kuro68k/Volume-Control/README.md

# Volume-Control
USB volume control and companion app
