kuro68k/Volume-Control/research/lighthouse-bi-colour-red-white-dimensions.jpg

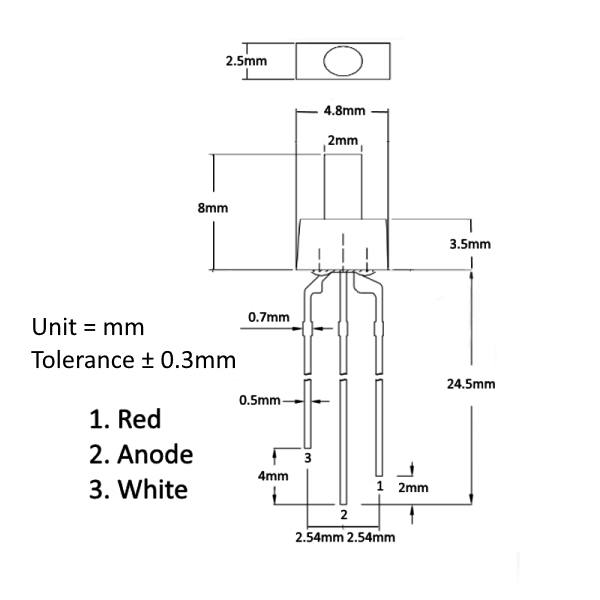
research/lighthouse-bi-colour-red-white-dimensions.jpg
