kuro68k/Volume-Control/hardware/usb_volume_control - Digikey 2026-02-26.ods

Reference | Qty | Value | Footprint | Description
C1 | 1 | 470n | Capacitor_SMD:C_0805_2012Metric_Pad1.18x1.45mm_HandSolder | Unpolarized capacitor
C2,C3,C5 | 3 | 100n | Capacitor_SMD:C_0805_2012Metric_Pad1.18x1.45mm_HandSolder | Unpolarized capacitor
C10 | 1 | 10u | Capacitor_SMD:C_0805_2012Metric_Pad1.18x1.45mm_HandSolder | Unpolarized capacitor
D1,D2,D3,D4,D5 | 5 | RW | LED_THT:LED_D3.0mm-3 | Dual LED, common anode on pin 2
H1,H2 | 2 | MountingHole_Pad | AliExpress M3 Bracket:MountingBracket_3.2mm_M3_Pad_tall | Mounting Hole with connection
J1 | 1 | AVR-PDI-6 | Connector_PinHeader_2.54mm:PinHeader_2x03_P2.54mm_Vertical | Atmel 6-pin PDI connector
J2 | 1 | USB_C_Skt_USB2.0_16P | Connector_USB:USB_C_Receptacle_GCT_USB4105-xx-A_16P_TopMnt_Horizontal | USB 2.0-only 16P Type-C Receptacle connector
J3 | 1 | RGB_LED | Connector_PinHeader_2.54mm:PinHeader_1x04_P2.54mm_Vertical | Generic connector, single row, 01x04, script generated (kicad-library-utils/schlib/autogen/connector/)
J4 | 1 | CAPBTN | Connector_PinHeader_2.54mm:PinHeader_1x04_P2.54mm_Vertical | Generic connector, single row, 01x04, script generated (kicad-library-utils/schlib/autogen/connector/)
J5 | 1 | ENC | Connector_PinHeader_2.54mm:PinHeader_1x03_P2.54mm_Vertical | Generic connector, single row, 01x03, script generated (kicad-library-utils/schlib/autogen/connector/)
J6 | 1 | BTN | Connector_PinHeader_2.54mm:PinHeader_1x02_P2.54mm_Vertical | Generic connector, single row, 01x02, script generated (kicad-library-utils/schlib/autogen/connector/)
R1,R2 | 2 | 5k6 | Resistor_SMD:R_0805_2012Metric_Pad1.20x1.40mm_HandSolder | Resistor
R3,R4,R5,R6,R7,R8,R9,R10,R11,R12 | 10 | 470 | Resistor_SMD:R_0805_2012Metric_Pad1.20x1.40mm_HandSolder | Resistor
U1 | 1 | AVR16DU14 | Package_SO:SOIC-14_3.9x8.7mm_P1.27mm | AVR microcontroller, 16kB flash, USB
U2,U3 | 2 | SN74ACT596 | Package_SO:TSSOP-16_4.4x5mm_P0.65mm | 8-bit serial in/out Shift Register Open Collector Outputs
