kuro68k/Volume-Control/CAD/EM14RXD-M20-L.stp

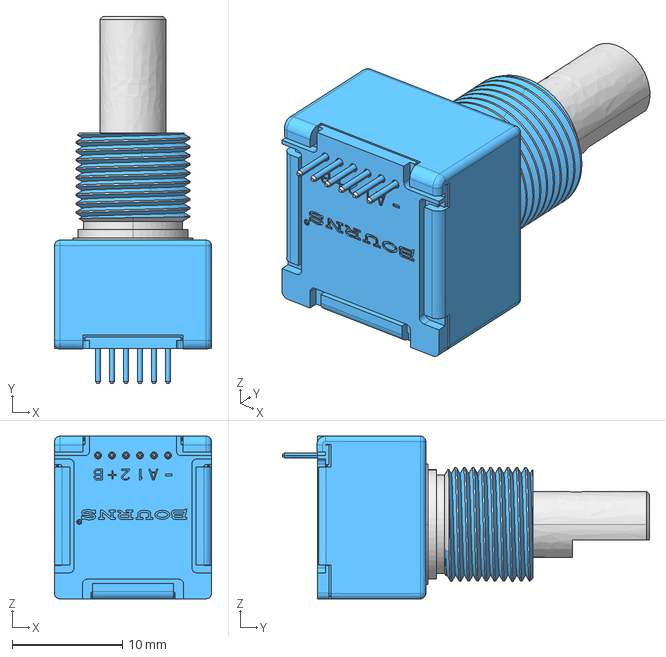
[picture p2: CAD file, 2026-02-12]
CAD/EM14RXD-M20-L.stp
14.2 x 33.3 x 14.8 mm
