kuro68k/Volume-Control/CAD/other/knob_20mm_6mm_shaft.stl

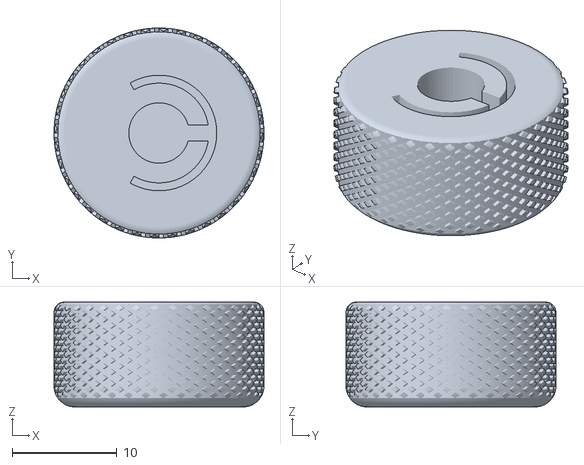
[picture p3: CAD file, 2026-02-12]
CAD/other/knob_20mm_6mm_shaft.stl
20.0 x 20.0 x 10.0
