kuro68k/Volume-Control/CAD/output/enclosure EX11-3-8 Front Plate.step

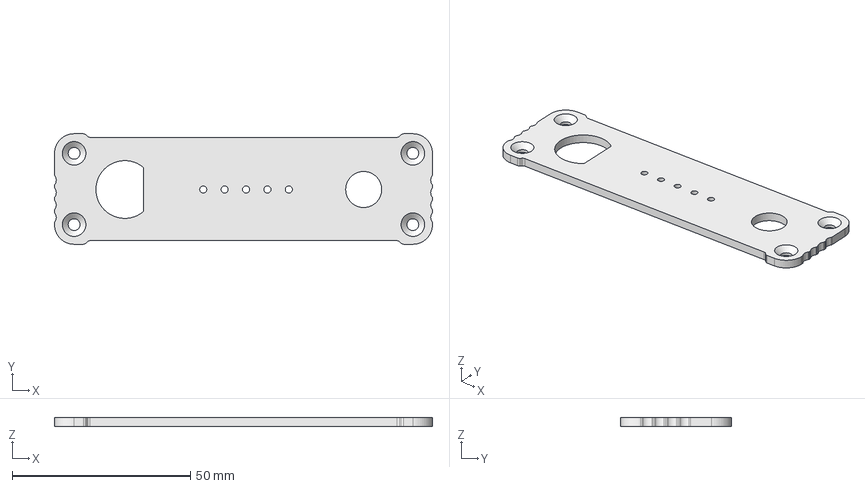
[picture p4: CAD file, 2026-02-13]
CAD/output/enclosure EX11-3-8 Front Plate.step
106.0 x 31.0 x 2.50 mm
