kuro68k/Volume-Control/usb_volume_control.step

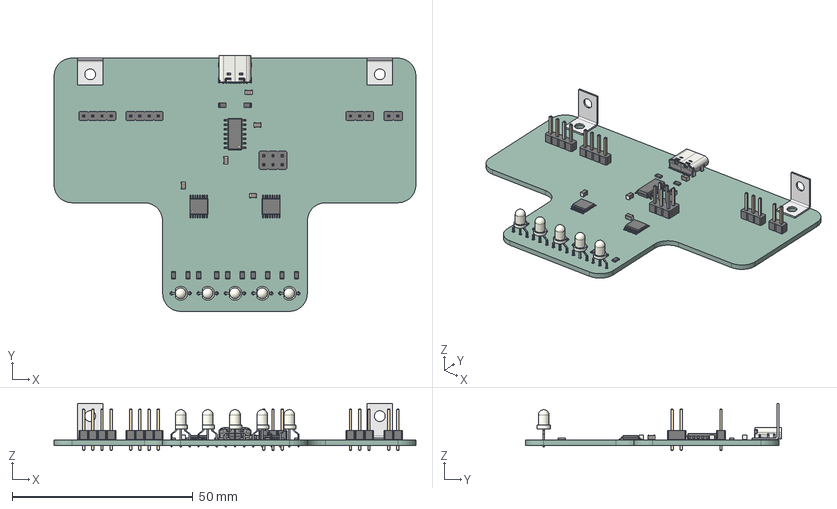
[picture p5: CAD file, 2026-02-13]
usb_volume_control.step
100.0 x 70.7 x 13.0 mm
C_0805_2012Metric x 5
R_0805_2012Metric x 12
PinHeader_1x02_P2.54mm_Vertical
USB_C_Receptacle_GCT_USB4105-xx-A_16P_TopMnt_Horizontal
LED_D3.0mm-3 x 5
PinHeader_1x04_P2.54mm_Vertical x 2
SOIC-14_3.9x8.7mm_P1.27mm
PinHeader_2x03_P2.54mm_Vertical
AliExpress M3 Bracket-Body x 2
TSSOP-16_4.4x5mm_P0.65mm x 2
PinHeader_1x03_P2.54mm_Vertical
usb_volume_control_PCB
