kuro68k/Volume-Control/CAD/enclosure EX11-3-8.FCStd

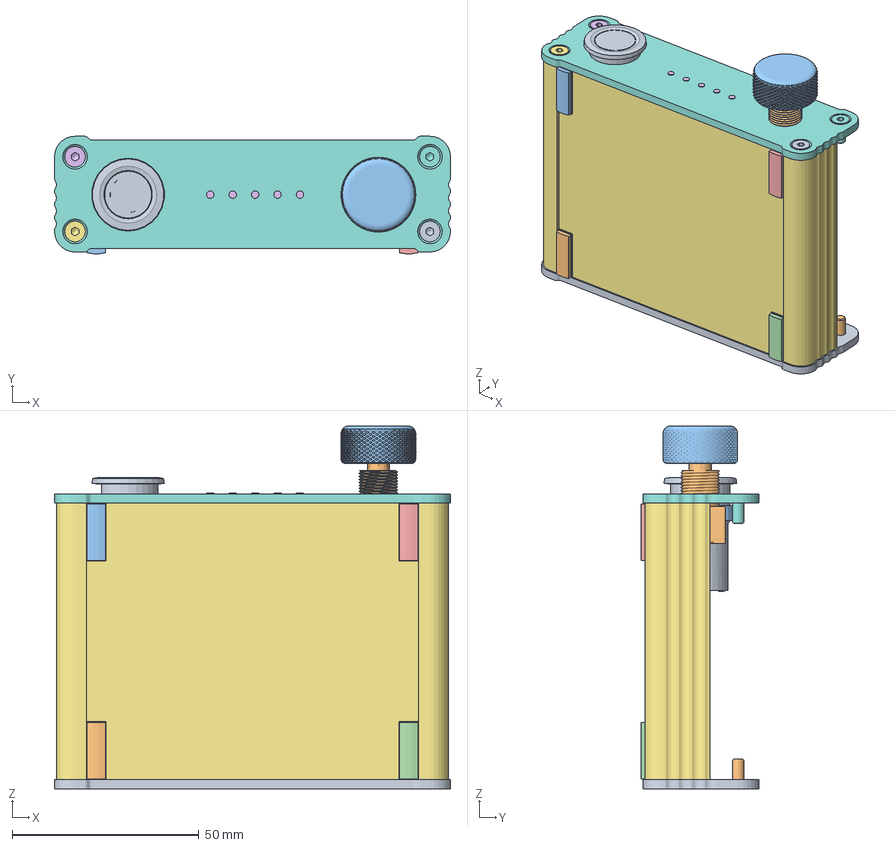
[picture p6: CAD file, 2026-02-12]
CAD/enclosure EX11-3-8.FCStd
106.0 x 31.5 x 97.2 mm
Kopie von CPS16RIWF^CPS16RIWF_01
Kopie von 0473.9211^CPS16RIWF_01
6kt-Mutter M16_01
Kopie von 0151.8560.1-19.2_Molex_Stecker_510210400~0^Kopie von D10-001-512_CPS16RIWF_01
Kopie von 0151.8560.1-19.3_Molex_Crimpkontakt_500798000~0^Kopie von D10-001-512_CPS16RIWF_01
Kopie von 0151.8560.1-19.3_Molex_Crimpkontakt_500798000~0^Kopie von D10-001-512_CPS16RIWF_002
Kopie von 0151.8560.1-19.3_Molex_Crimpkontakt_500798000~0^Kopie von D10-001-512_CPS16RIWF_003
Kopie von 0151.8560.1-19.3_Molex_Crimpkontakt_500798000~0^Kopie von D10-001-512_CPS16RIWF_004
Kopie von 0151.8560.1-19.5_BN_Cu-Litze~0^Kopie von D10-001-512_CPS16RIWF_01
Kopie von 0151.8560.1-19.5_BK_Cu-Litze~0^Kopie von D10-001-512_CPS16RIWF_01
Kopie von 0151.8560.1-19.5_WH_Cu-Litze~0^Kopie von D10-001-512_CPS16RIWF_01
Kopie von 0151.8560.1-19.5_WH_Cu-Litze~0^Kopie von D10-001-512_CPS16RIWF_002
Kopie von 0151.8560.1-19.2_Molex_Stecker_510210400~0^Kopie von D10-001-512_CPS16RIWF_002
Kopie von 0151.8560.1-19.3_Molex_Crimpkontakt_500798000~0^Kopie von D10-001-512_CPS16RIWF_005
Kopie von 0151.8560.1-19.3_Molex_Crimpkontakt_500798000~0^Kopie von D10-001-512_CPS16RIWF_006
Kopie von 0151.8560.1-19.3_Molex_Crimpkontakt_500798000~0^Kopie von D10-001-512_CPS16RIWF_007
Kopie von 0151.8560.1-19.3_Molex_Crimpkontakt_500798000~0^Kopie von D10-001-512_CPS16RIWF_008
Kopie von 0151.8560.1-19.5_RD_Cu-Litze~0^Kopie von D10-001-512_CPS16RIWF_01
Kopie von 0151.8560.1-19.5_GN_Cu-Litze~0^Kopie von D10-001-512_CPS16RIWF_01
Kopie von 0151.8560.1-19.5_BU_Cu-Litze~0^Kopie von D10-001-512_CPS16RIWF_01
Kopie von 0151.8560.1-19.5_BK_Cu-Litze~0^Kopie von D10-001-512_CPS16RIWF_002
\X2\4E0B30AB30D030FC\X0\105-3-74
105-3\X2\30D130CD30EB\X0\
105-3\X2\30D130CD30EB\X0\001
ISO 10642 M3 x 8
ISO 10642 M3 x 009
ISO 10642 M3 x 010
ISO 10642 M3 x 011
ISO 10642 M3 x 012
ISO 10642 M3 x 013
ISO 10642 M3 x 014
ISO 10642 M3 x 015
SJ-1011
SJ-1012
SJ-1013
SJ-1014
C_0805_2012Metric
C_0805_2012Metric001
R_0805_2012Metric
PinHeader_1x02_P2.54mm_Vertical
R_0805_2012Metric001
R_0805_2012Metric002
LED_D3.0mm-3
USB_C_Receptacle_GCT_USB4105-xx-A_16P_TopMnt_Horizontal
LED_D3.0mm-004
C_0805_2012Metric002
R_0805_2012Metric003
R_0805_2012Metric004
C_0805_2012Metric003
PinHeader_1x04_P2.54mm_Vertical
SOIC-14_3.9x8.7mm_P1.27mm
PinHeader_2x03_P2.54mm_Vertical
R_0805_2012Metric005
R_0805_2012Metric006
PinHeader_1x04_P2.54mm_Vertical001
R_0805_2012Metric007
LED_D3.0mm-005
LED_D3.0mm-006
TSSOP-16_4.4x5mm_P0.65mm
R_0805_2012Metric008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
