kuro68k/Volume-Control/CAD/other/EX11-3-8 □.stp

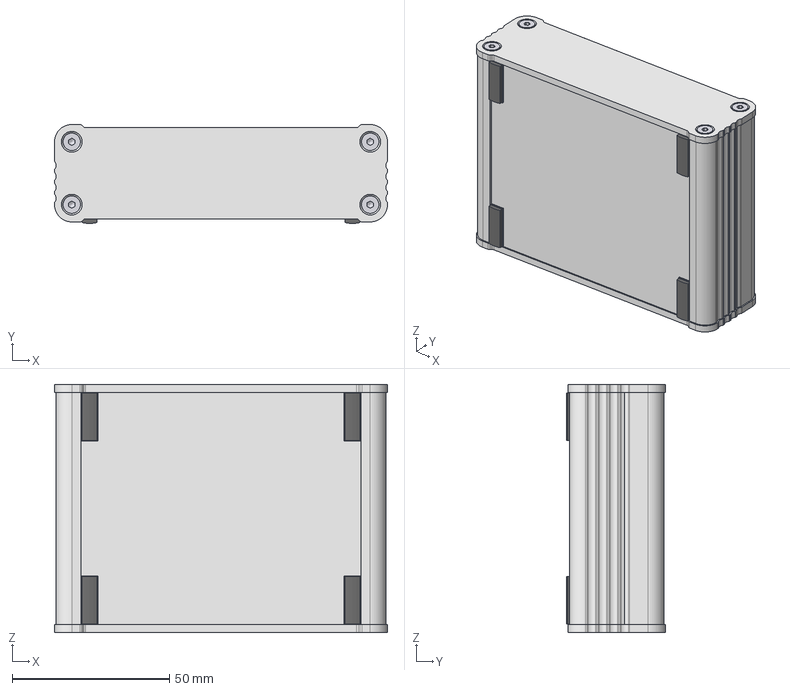
[picture p7: CAD file, 2026-02-12]
CAD/other/EX11-3-8 □.stp
106.0 x 31.5 x 79.0 mm
下カバー105-3-74
上カバー105-74
105-3パネル x 2
ISO 10642 M3 x 8 x 8
SJ-1011 x 4
