kuro68k/Volume-Control/CAD/output/enclosure EX11-3-8 Back Plate.step

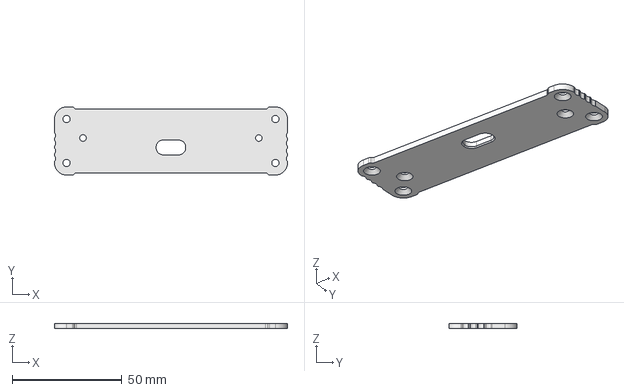
[picture p8: CAD file, 2026-02-13]
CAD/output/enclosure EX11-3-8 Back Plate.step
106.0 x 31.0 x 2.50 mm
