kuro68k/Volume-Control/CAD/AliExpress M3 Bracket.FCStd

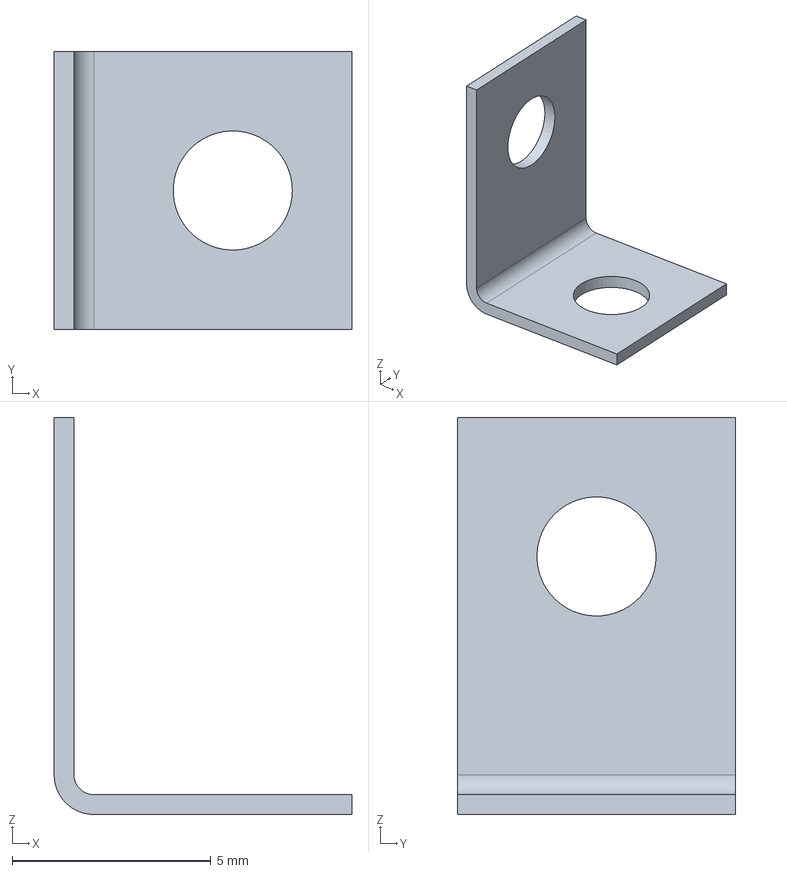
[picture p9: CAD file, 2026-02-12]
CAD/AliExpress M3 Bracket.FCStd
7.50 x 7.00 x 10.0 mm
