kuro68k/Volume-Control/CAD/other/K93-10436-H6-L120.STEP

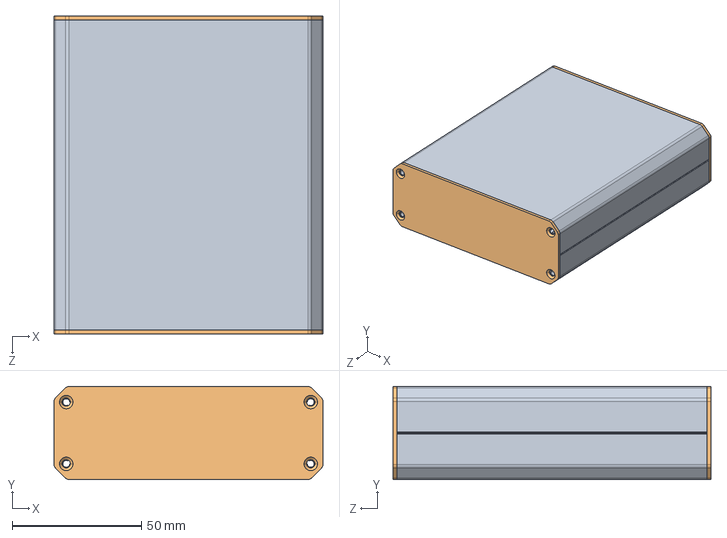
[picture p10: CAD file, 2026-02-12]
CAD/other/K93-10436-H6-L120.STEP
104.0 x 36.0 x 123.0 mm
K93-1 x 2
K93-B x 2
