kuro68k/Volume-Control/CAD/ena1d-b28-l00128l.stp

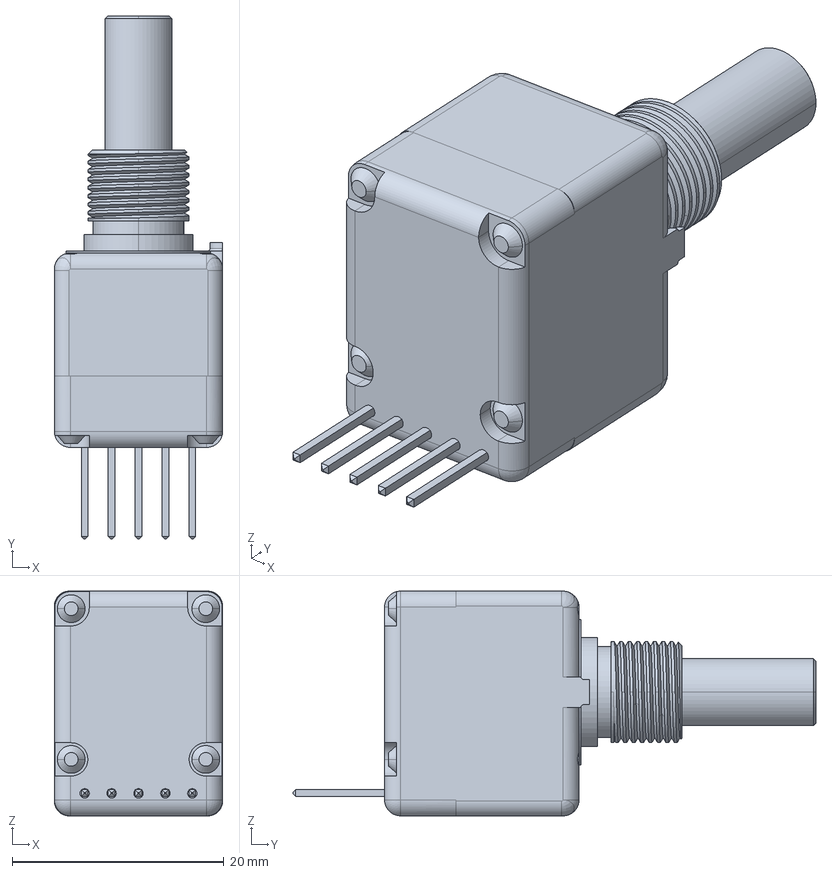
[picture p11: CAD file, 2026-02-12]
CAD/ena1d-b28-l00128l.stp
15.9 x 49.4 x 21.2 mm
