kuro68k/Volume-Control/CAD/other/K48-7125-H6-L100.STEP

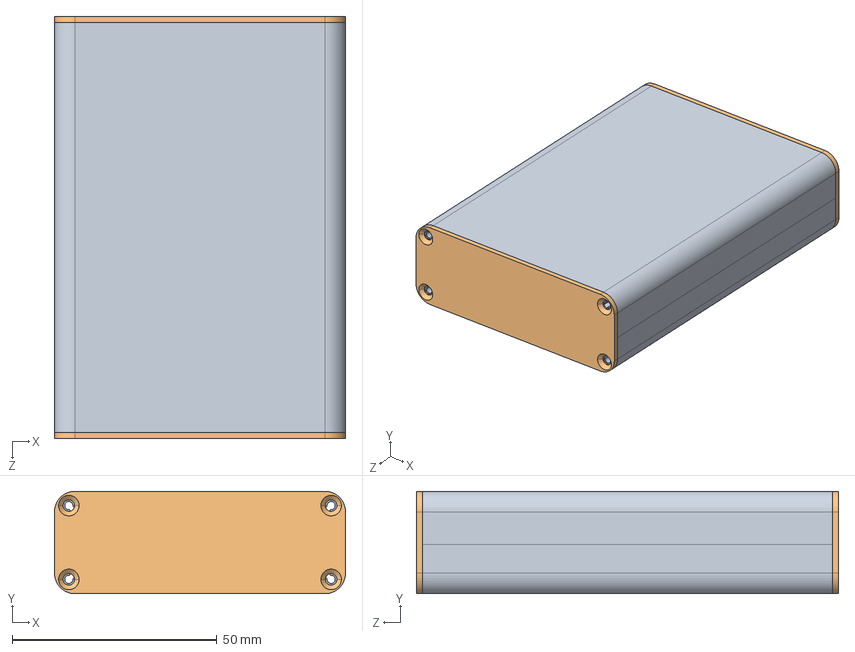
[picture p12: CAD file, 2026-02-12]
CAD/other/K48-7125-H6-L100.STEP
71.0 x 25.0 x 103.0 mm
K48-1 x 2
K48-B x 2
