kuro68k/Volume-Control/CAD/enclosure MXA3-11-7.FCStd

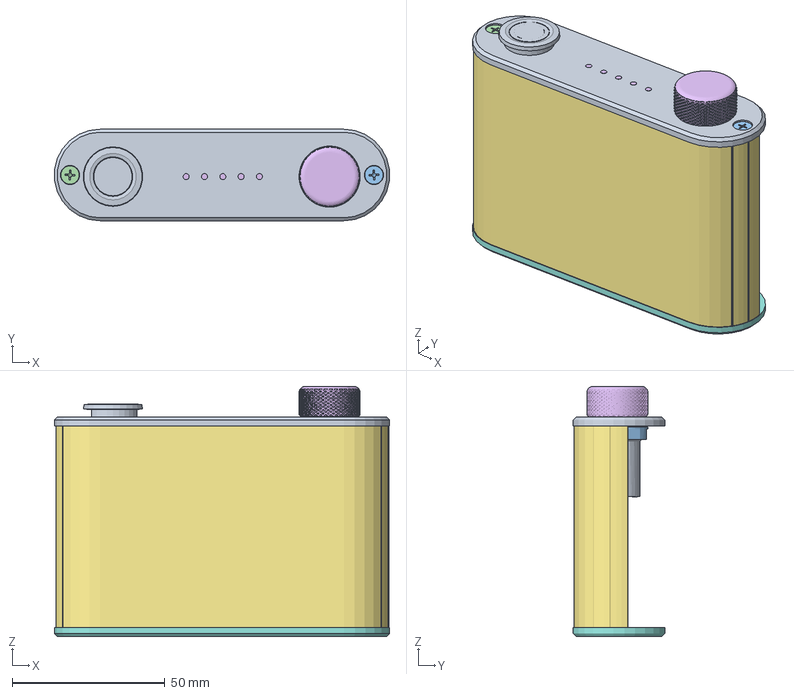
[picture p13: CAD file, 2026-02-12]
CAD/enclosure MXA3-11-7.FCStd
109.8 x 30.0 x 82.0 mm
Kopie von CPS16RIWF^CPS16RIWF_01
Kopie von 0473.9211^CPS16RIWF_01
6kt-Mutter M16_01
Kopie von 0151.8560.1-19.2_Molex_Stecker_510210400~0^Kopie von D10-001-512_CPS16RIWF_01
Kopie von 0151.8560.1-19.3_Molex_Crimpkontakt_500798000~0^Kopie von D10-001-512_CPS16RIWF_01
Kopie von 0151.8560.1-19.3_Molex_Crimpkontakt_500798000~0^Kopie von D10-001-512_CPS16RIWF_002
Kopie von 0151.8560.1-19.3_Molex_Crimpkontakt_500798000~0^Kopie von D10-001-512_CPS16RIWF_003
Kopie von 0151.8560.1-19.3_Molex_Crimpkontakt_500798000~0^Kopie von D10-001-512_CPS16RIWF_004
Kopie von 0151.8560.1-19.5_BN_Cu-Litze~0^Kopie von D10-001-512_CPS16RIWF_01
Kopie von 0151.8560.1-19.5_BK_Cu-Litze~0^Kopie von D10-001-512_CPS16RIWF_01
Kopie von 0151.8560.1-19.5_WH_Cu-Litze~0^Kopie von D10-001-512_CPS16RIWF_01
Kopie von 0151.8560.1-19.5_WH_Cu-Litze~0^Kopie von D10-001-512_CPS16RIWF_002
Kopie von 0151.8560.1-19.2_Molex_Stecker_510210400~0^Kopie von D10-001-512_CPS16RIWF_002
Kopie von 0151.8560.1-19.3_Molex_Crimpkontakt_500798000~0^Kopie von D10-001-512_CPS16RIWF_005
Kopie von 0151.8560.1-19.3_Molex_Crimpkontakt_500798000~0^Kopie von D10-001-512_CPS16RIWF_006
Kopie von 0151.8560.1-19.3_Molex_Crimpkontakt_500798000~0^Kopie von D10-001-512_CPS16RIWF_007
Kopie von 0151.8560.1-19.3_Molex_Crimpkontakt_500798000~0^Kopie von D10-001-512_CPS16RIWF_008
Kopie von 0151.8560.1-19.5_RD_Cu-Litze~0^Kopie von D10-001-512_CPS16RIWF_01
Kopie von 0151.8560.1-19.5_GN_Cu-Litze~0^Kopie von D10-001-512_CPS16RIWF_01
Kopie von 0151.8560.1-19.5_BU_Cu-Litze~0^Kopie von D10-001-512_CPS16RIWF_01
Kopie von 0151.8560.1-19.5_BK_Cu-Litze~0^Kopie von D10-001-512_CPS16RIWF_002
MXA3_11_7___001
MXA3_11_7___002
MXA3_11_7___003
MXA3_11_7___004
MXA3_11_7___005
MXA3_11_7___006
MXA3_11_7___007
knob_20mm_6mm_shaft
