kuro68k/Volume-Control/CAD/enclosure 3.FCStd

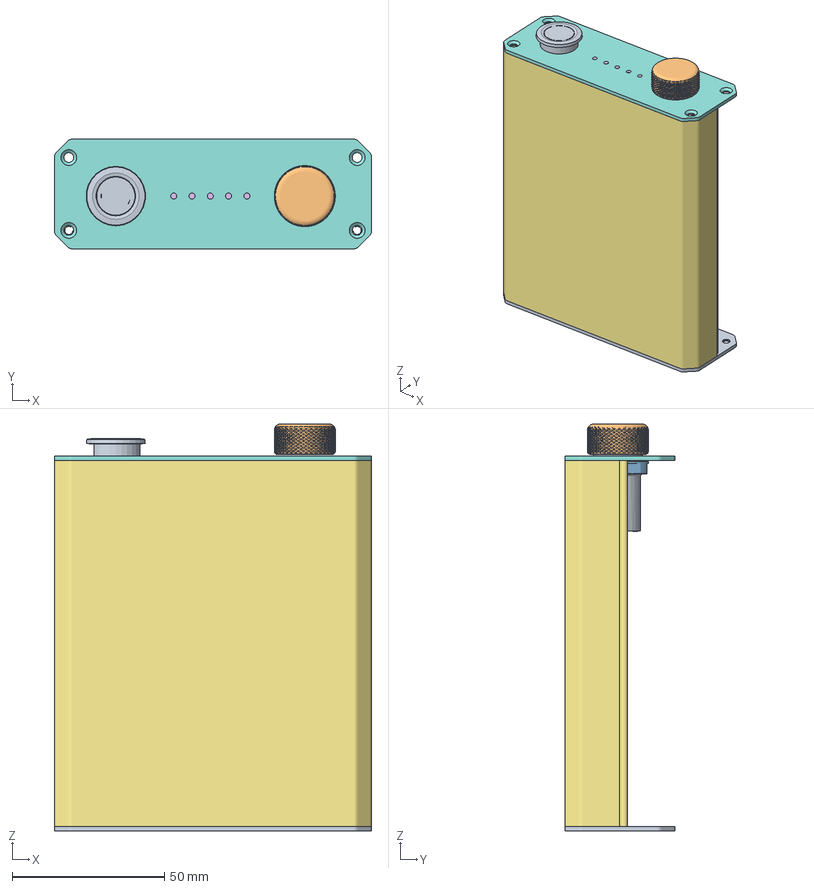
[picture p14: CAD file, 2026-02-12]
CAD/enclosure 3.FCStd
104.0 x 36.0 x 133.5 mm
Kopie von CPS16RIWF^CPS16RIWF_01
Kopie von 0473.9211^CPS16RIWF_01
6kt-Mutter M16_01
Kopie von 0151.8560.1-19.2_Molex_Stecker_510210400~0^Kopie von D10-001-512_CPS16RIWF_01
Kopie von 0151.8560.1-19.3_Molex_Crimpkontakt_500798000~0^Kopie von D10-001-512_CPS16RIWF_01
Kopie von 0151.8560.1-19.3_Molex_Crimpkontakt_500798000~0^Kopie von D10-001-512_CPS16RIWF_002
Kopie von 0151.8560.1-19.3_Molex_Crimpkontakt_500798000~0^Kopie von D10-001-512_CPS16RIWF_003
Kopie von 0151.8560.1-19.3_Molex_Crimpkontakt_500798000~0^Kopie von D10-001-512_CPS16RIWF_004
Kopie von 0151.8560.1-19.5_BN_Cu-Litze~0^Kopie von D10-001-512_CPS16RIWF_01
Kopie von 0151.8560.1-19.5_BK_Cu-Litze~0^Kopie von D10-001-512_CPS16RIWF_01
Kopie von 0151.8560.1-19.5_WH_Cu-Litze~0^Kopie von D10-001-512_CPS16RIWF_01
Kopie von 0151.8560.1-19.5_WH_Cu-Litze~0^Kopie von D10-001-512_CPS16RIWF_002
Kopie von 0151.8560.1-19.2_Molex_Stecker_510210400~0^Kopie von D10-001-512_CPS16RIWF_002
Kopie von 0151.8560.1-19.3_Molex_Crimpkontakt_500798000~0^Kopie von D10-001-512_CPS16RIWF_005
Kopie von 0151.8560.1-19.3_Molex_Crimpkontakt_500798000~0^Kopie von D10-001-512_CPS16RIWF_006
Kopie von 0151.8560.1-19.3_Molex_Crimpkontakt_500798000~0^Kopie von D10-001-512_CPS16RIWF_007
Kopie von 0151.8560.1-19.3_Molex_Crimpkontakt_500798000~0^Kopie von D10-001-512_CPS16RIWF_008
Kopie von 0151.8560.1-19.5_RD_Cu-Litze~0^Kopie von D10-001-512_CPS16RIWF_01
Kopie von 0151.8560.1-19.5_GN_Cu-Litze~0^Kopie von D10-001-512_CPS16RIWF_01
Kopie von 0151.8560.1-19.5_BU_Cu-Litze~0^Kopie von D10-001-512_CPS16RIWF_01
Kopie von 0151.8560.1-19.5_BK_Cu-Litze~0^Kopie von D10-001-512_CPS16RIWF_002
K93-1
K93-B
K93-B001
knob_20mm_6mm_shaft
