kuro68k/Volume-Control/CAD/other/USB C Panel Mount Extension.step

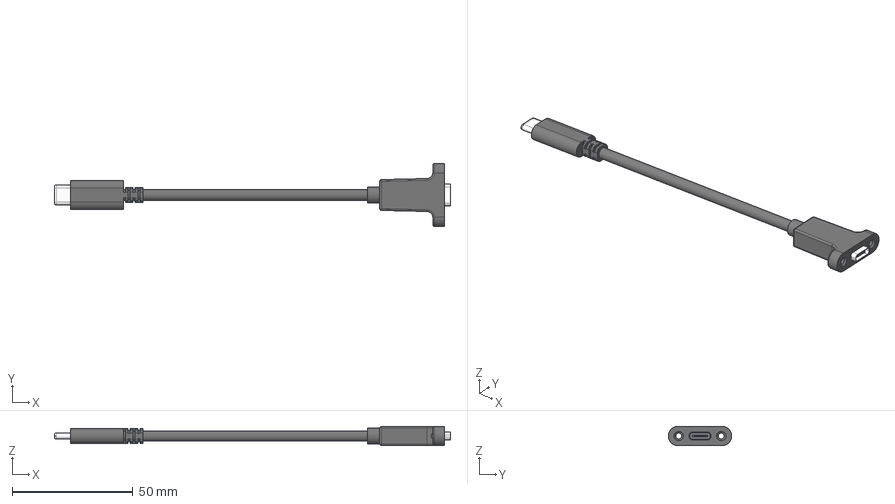
[picture p15: CAD file, 2026-02-12]
CAD/other/USB C Panel Mount Extension.step
164.0 x 26.2 x 8.00 mm
Male USB C
USB C cord
Female USB C
