kuro68k/Volume-Control/CAD/other/HD10-5-10S.stp

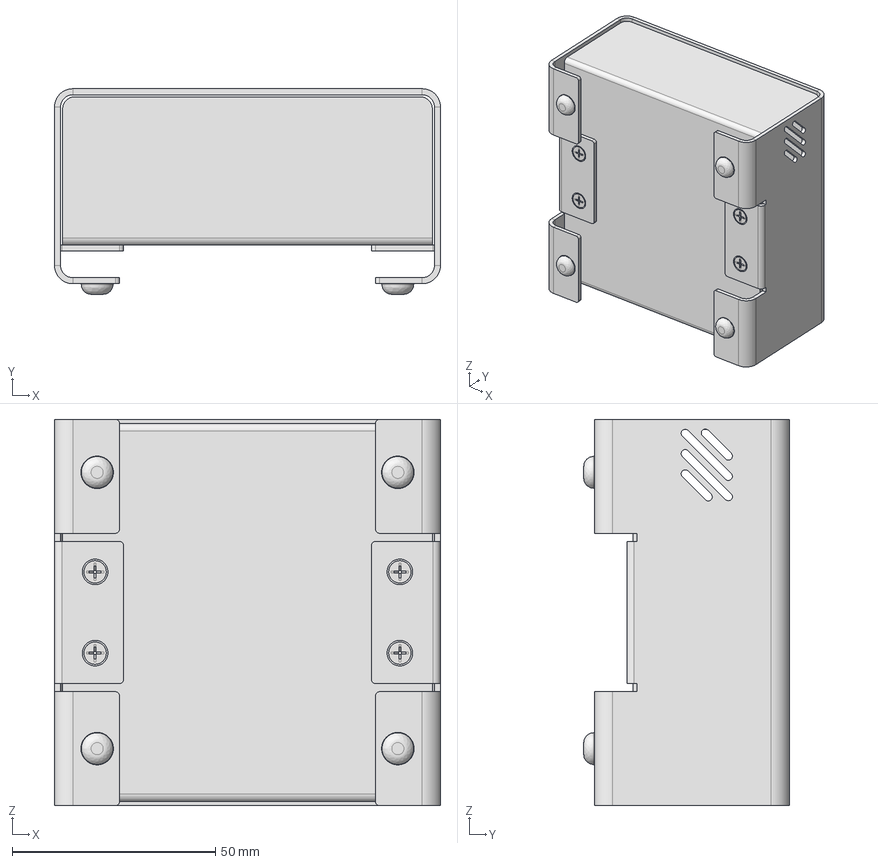
[picture p16: CAD file, 2026-02-12]
CAD/other/HD10-5-10S.stp
95.0 x 50.6 x 95.0 mm
HD10-5-10S カバー
HD10-5-10S シャーシ
JIS B 1111 (H) - M3x4 - 4.8 - H x 4
ゴム足(TB-8) x 4
