kuro68k/Volume-Control/CAD/other/MXA3-11-7□.stp

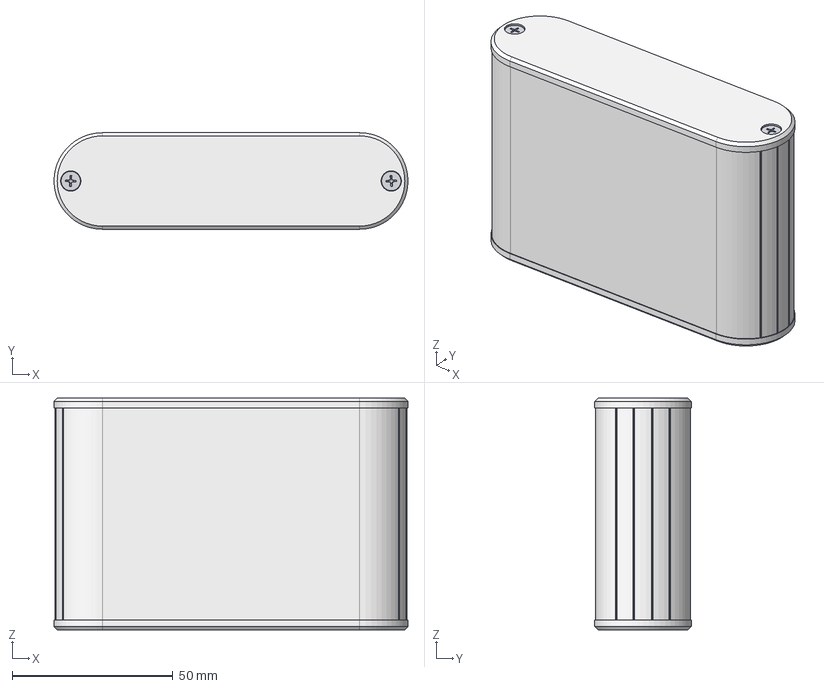
[picture p17: CAD file, 2026-02-12]
CAD/other/MXA3-11-7□.stp
110.0 x 30.0 x 72.0 mm
MX3-11-8本体フレーム x 2
ＭＸＡパネル3-11 x 2
JIS B 1122 - ST3.0 x10 x 4
