kuro68k/Volume-Control/CAD/other/HD11-5-18S.stp

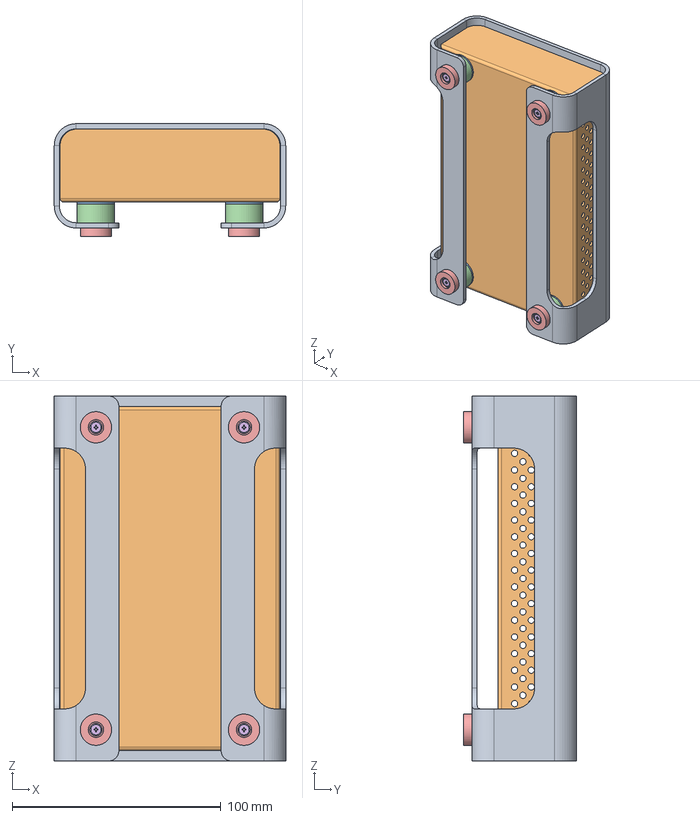
[picture p18: CAD file, 2026-02-12]
CAD/other/HD11-5-18S.stp
111.0 x 54.0 x 175.0 mm
HD11-5-18S カバー
HD11-5-18S シャーシ
支柱足用スポンジ x 4
支柱足 x 4
ゴム足(B-P1M) x 4
CSPSL-ST3W-M3-16_203 x 4
