kuro68k/Volume-Control/CAD/other/3-101-412.stp

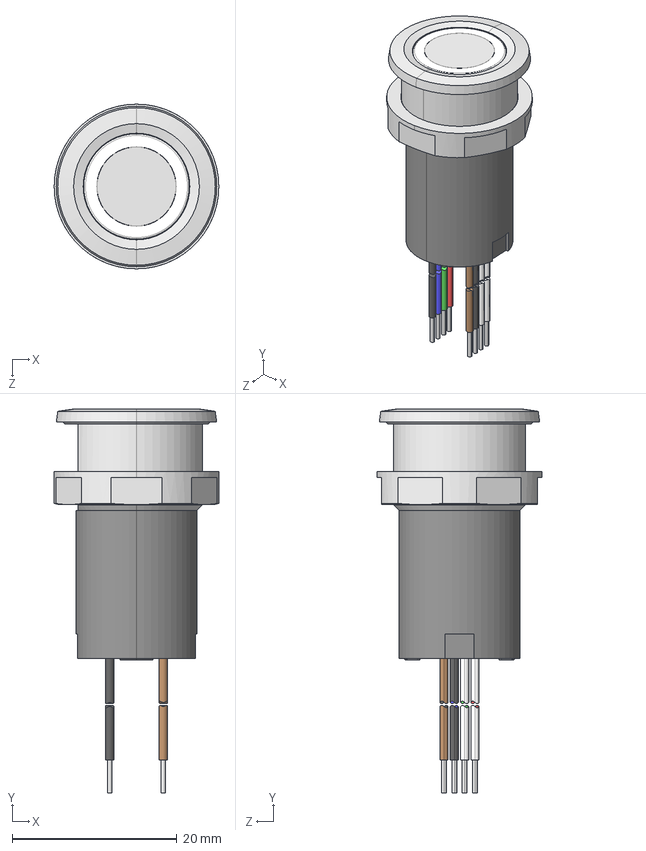
[picture p19: CAD file, 2026-02-12]
CAD/other/3-101-412.stp
20.0 x 46.6 x 20.0 mm
Kopie von CPS16RIWF^CPS16RIWF_01
Kopie von 0473.9211^CPS16RIWF_01
6kt-Mutter M16_01
Kopie von 0151.8560.1-19.2_Molex_Stecker_510210400~0^Kopie von D10-001-512_CPS16RIWF_01 x 2
Kopie von 0151.8560.1-19.3_Molex_Crimpkontakt_500798000~0^Kopie von D10-001-512_CPS16RIWF_01 x 8
Kopie von 0151.8560.1-19.5_BN_Cu-Litze~0^Kopie von D10-001-512_CPS16RIWF_01
Kopie von 0151.8560.1-19.5_BK_Cu-Litze~0^Kopie von D10-001-512_CPS16RIWF_01 x 2
Kopie von 0151.8560.1-19.5_WH_Cu-Litze~0^Kopie von D10-001-512_CPS16RIWF_01 x 2
Kopie von 0151.8560.1-19.5_RD_Cu-Litze~0^Kopie von D10-001-512_CPS16RIWF_01
Kopie von 0151.8560.1-19.5_GN_Cu-Litze~0^Kopie von D10-001-512_CPS16RIWF_01
Kopie von 0151.8560.1-19.5_BU_Cu-Litze~0^Kopie von D10-001-512_CPS16RIWF_01
