kuro68k/Volume-Control/(list of files, cad)

Other CAD files:
CAD/other/usb_volume_control.step
