kuro68k/Volume-Control/hardware/plot/usb_volume_control.pdf

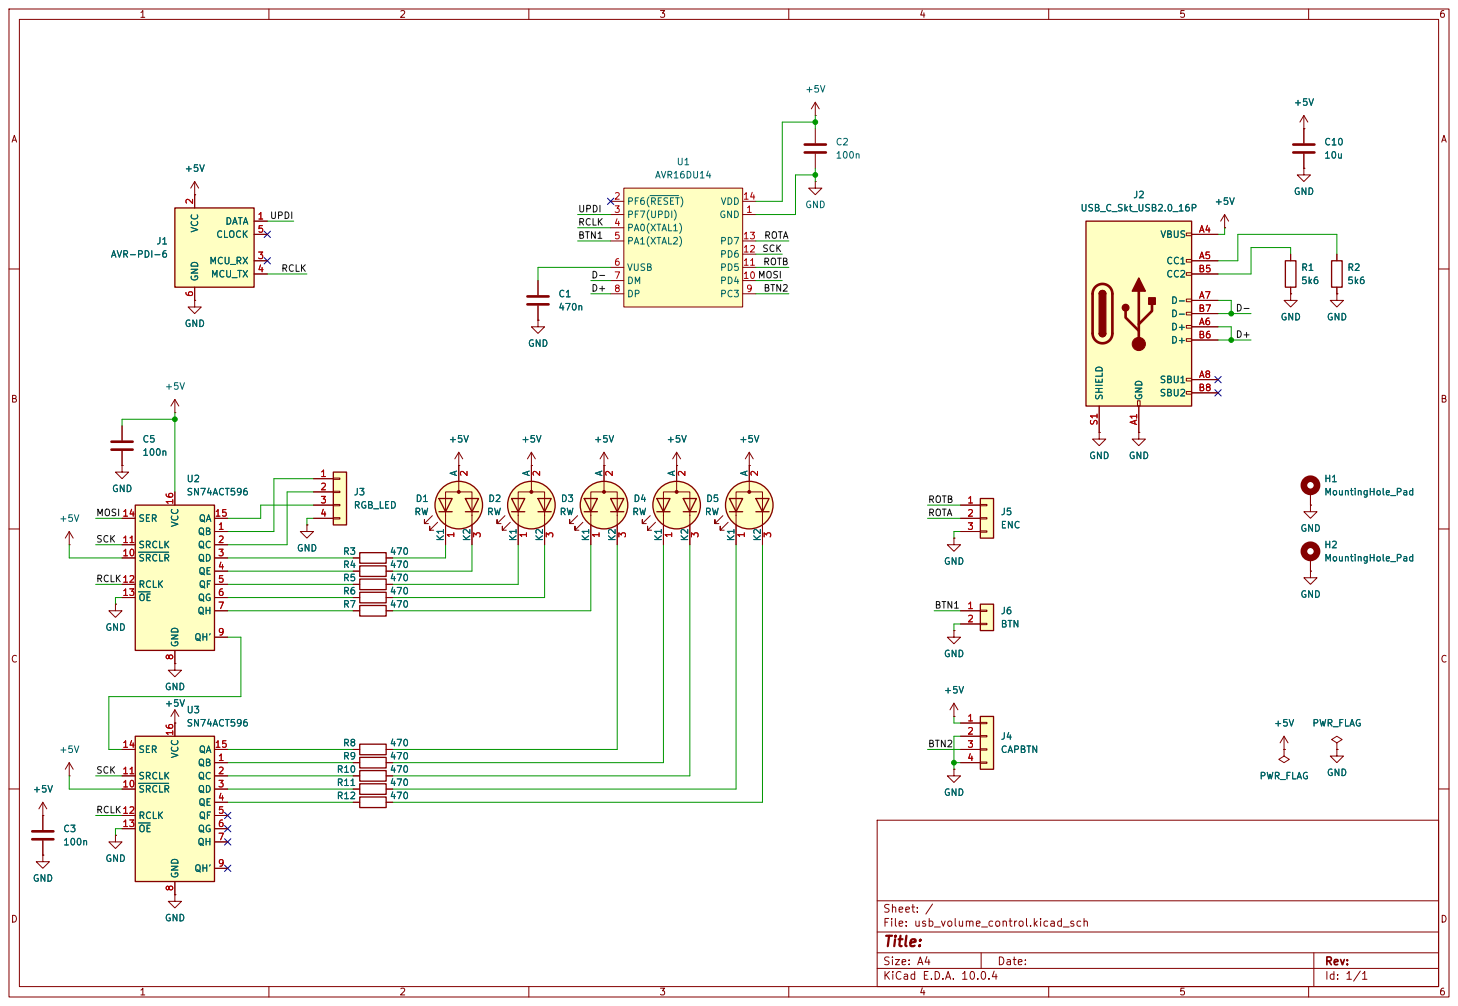
[picture p20: page 1]

SRCLR 10 SRCLK 11 RCLK 12 OE 13

Size: A4 | Rev:
KiCad E.D.A. 10.0.4 | Id: 1/1
