kuro68k/Volume-Control/hardware/usb_volume_control.kicad_pcb

## KiCad design hardware/usb_volume_control.kicad_pcb (2026-02-25)

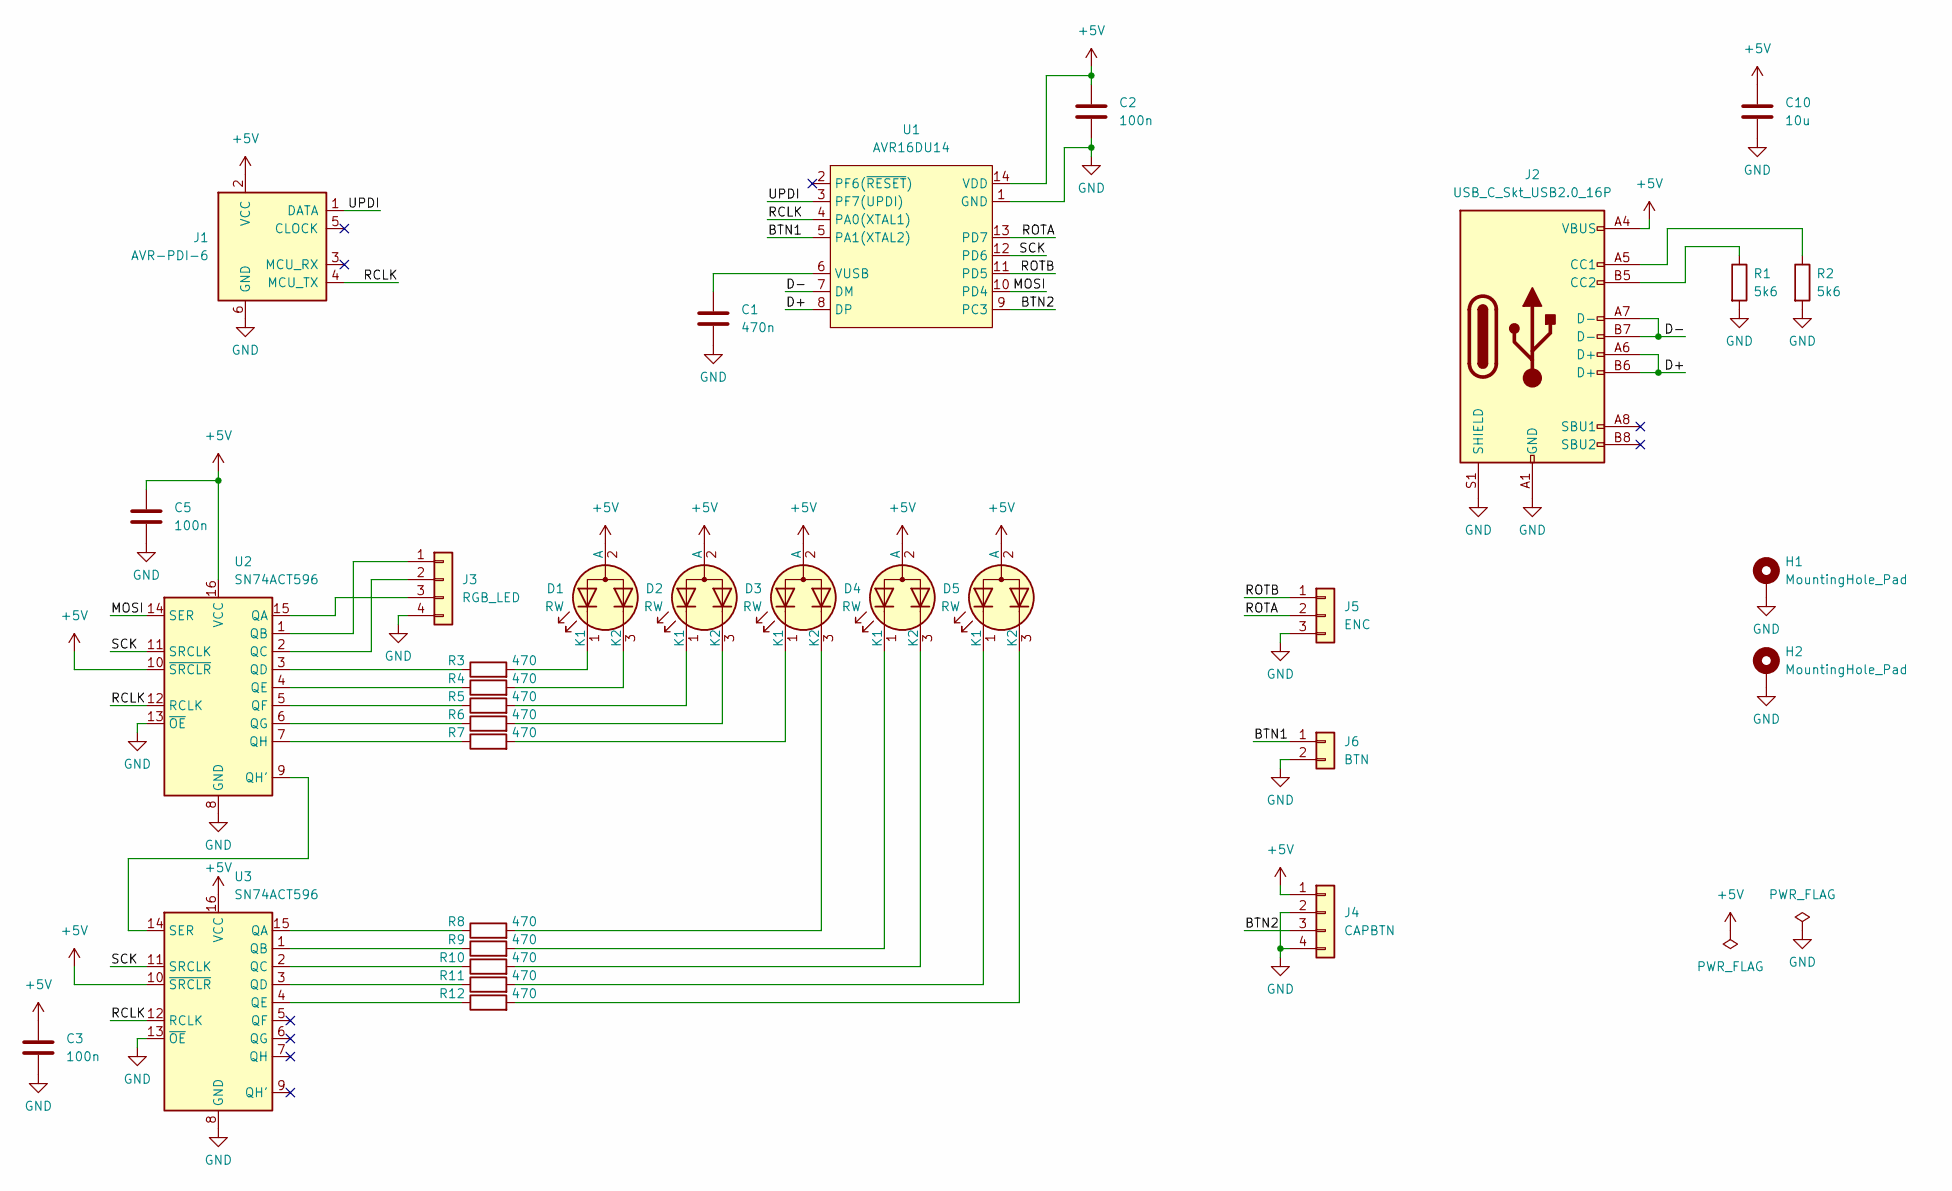
[picture p21: schematic usb_volume_control.kicad_sch]

Parts:
C1: 470n; C_0805_2012Metric_Pad1.18x1.45mm_HandSolder
C2, C3, C5: 100n; C_0805_2012Metric_Pad1.18x1.45mm_HandSolder
C10: 10u; C_0805_2012Metric_Pad1.18x1.45mm_HandSolder
D1, D2, D3, D4, D5: RW; LED_D3.0mm-3
H1, H2: MountingHole_Pad; MountingBracket_3.2mm_M3_Pad_tall
J1: AVR-PDI-6; PinHeader_2x03_P2.54mm_Vertical
J2: USB_C_Skt_USB2.0_16P; USB_C_Receptacle_GCT_USB4105-xx-A_16P_TopMnt_Horizontal
J3: RGB_LED; PinHeader_1x04_P2.54mm_Vertical
J4: CAPBTN; PinHeader_1x04_P2.54mm_Vertical
J5: ENC; PinHeader_1x03_P2.54mm_Vertical
J6: BTN; PinHeader_1x02_P2.54mm_Vertical
R1, R2: 5k6; R_0805_2012Metric_Pad1.20x1.40mm_HandSolder
R3, R4, R5, R6, R7, R8, R9, R10, R11, R12: 470; R_0805_2012Metric_Pad1.20x1.40mm_HandSolder
U1: AVR16DU14; SOIC-14_3.9x8.7mm_P1.27mm
U2, U3: SN74ACT596; TSSOP-16_4.4x5mm_P0.65mm

Connections:
+5V: C2.1, C3.1, C5.1, C10.1, D1.2 (A), D2.2 (A), D3.2 (A), D4.2 (A), D5.2 (A), J1.2 (VCC), J2.A4 (VBUS), J2.A9 (VBUS), J2.B4 (VBUS), J2.B9 (VBUS), J4.1, U1.14 (VDD), U2.10 (~SRCLR), U2.16 (VCC), U3.10 (~SRCLR), U3.16 (VCC)
/BTN1: J6.1, U1.5 (PA1(XTAL2))
/BTN2: J4.3, U1.9 (PC3)
/D+: J2.A6 (D+), J2.B6 (D+), U1.8 (DP)
/D-: J2.A7 (D-), J2.B7 (D-), U1.7 (DM)
/MOSI: U1.10 (PD4), U2.14 (SER)
/RCLK: J1.4 (MCU_TX), U1.4 (PA0(XTAL1)), U2.12 (RCLK), U3.12 (RCLK)
/ROTA: J5.2, U1.13 (PD7)
/ROTB: J5.1, U1.11 (PD5)
/SCK: U1.12 (PD6), U2.11 (SRCLK), U3.11 (SRCLK)
/UPDI: J1.1 (DATA), U1.3 (PF7(UPDI))
GND: C1.2, C2.2, C3.2, C5.2, C10.2, H1.1, H2.1, J1.6 (GND), J2.A1 (GND), J2.A12 (GND), J2.B1 (GND), J2.B12 (GND), J2.S1 (SHIELD), J3.4, J4.2, J4.4, J5.3, J6.2, R1.2, R2.2, U1.1 (GND), U2.8 (GND), U2.13 (~OE), U3.8 (GND), U3.13 (~OE)
unnamed: D1.1 (K1), R3.2
unnamed: D1.3 (K2), R4.2
unnamed: D2.1 (K1), R5.2
unnamed: D2.3 (K2), R6.2
unnamed: D3.1 (K1), R7.2
unnamed: D3.3 (K2), R8.2
unnamed: D4.1 (K1), R9.2
unnamed: D4.3 (K2), R10.2
unnamed: D5.1 (K1), R11.2
unnamed: D5.3 (K2), R12.2
unnamed: J2.A5 (CC1), R2.1
unnamed: J2.B5 (CC2), R1.1
unnamed: J3.1, U2.1 (QB)
unnamed: J3.2, U2.2 (QC)
unnamed: J3.3, U2.15 (QA)
unnamed: C1.1, U1.6 (VUSB)
unnamed: R3.1, U2.3 (QD)
unnamed: R4.1, U2.4 (QE)
unnamed: R5.1, U2.5 (QF)
unnamed: R6.1, U2.6 (QG)
unnamed: U2.9 (QH'), U3.14 (SER)
unnamed: R7.1, U2.7 (QH)
unnamed: R8.1, U3.15 (QA)
unnamed: R9.1, U3.1 (QB)
unnamed: R10.1, U3.2 (QC)
unnamed: R11.1, U3.3 (QD)
unnamed: R12.1, U3.4 (QE)

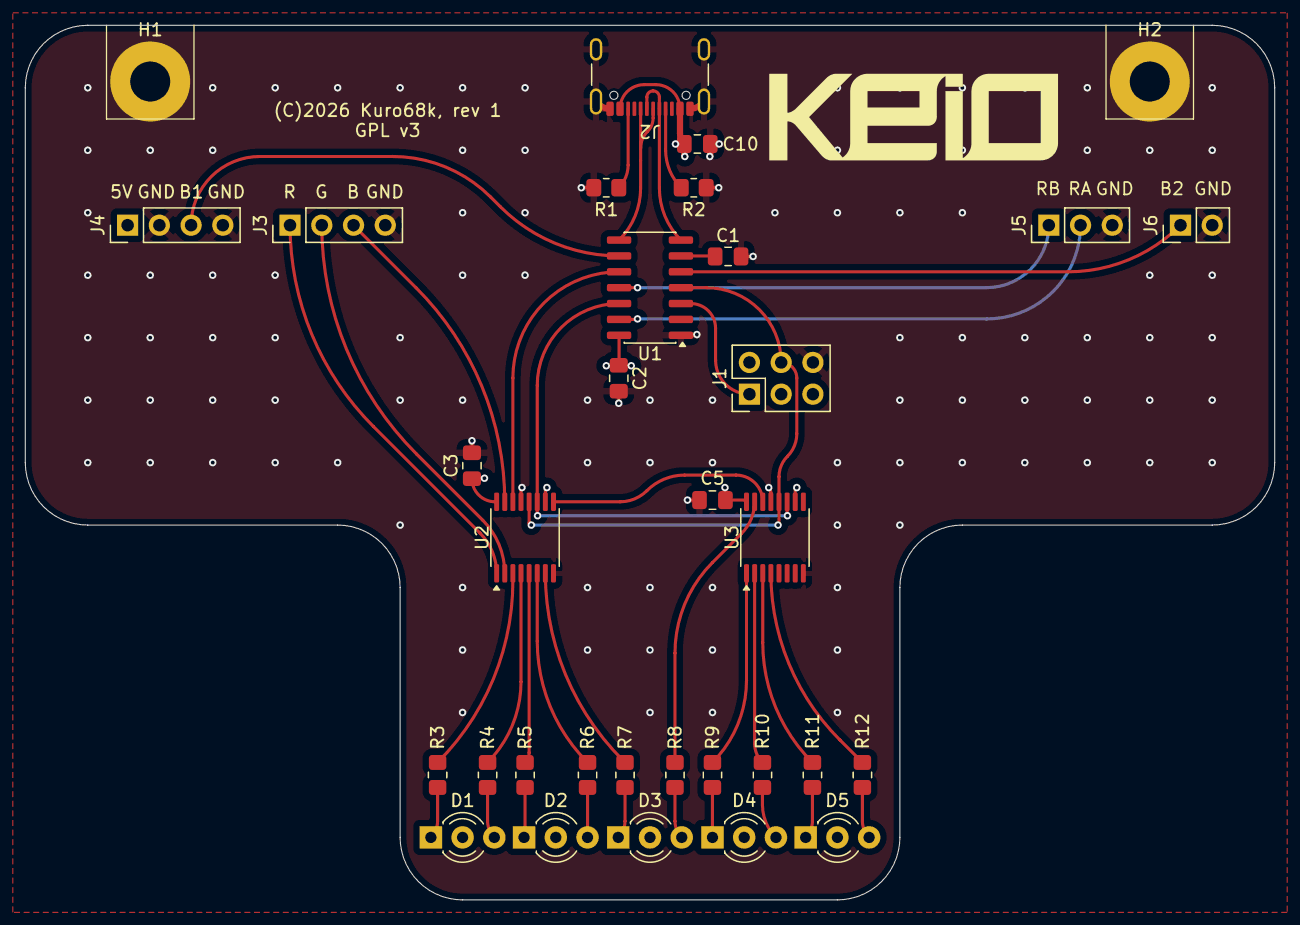
[picture p22: board usb_volume_control.kicad_pcb from above]

Board: 4 copper layers, 100.0 x 70.0 mm, 33 parts (0 on the bottom side), 39 nets.
