kuro68k/Volume-Control/(commit log)

2026-02-13 Finished PCB and imported to FreeCAD
    [enclosure EX11-3-8 Back Plate.step, enclosure EX11-3-8 Front Plate.step, usb_volume_control.kicad_pcb, usb_volume_control.step]
2026-02-25 Rev 1 production files
    [usb_volume_control.kicad_pcb]
2026-07-22 Rev 1 hardware as built
    [usb_volume_control - Digikey 2026-02-26.ods]
2026-07-23 Rev 2 to-do notes
    [usb_volume_control.kicad_sch]
2026-07-26 USB stack fixes and sleep mode
    [hw.c, main.c]
2026-07-27 LEDs off after wake
2026-07-27 Refresh LEDs after resume from sleep/hibernation
