kuro68k/Volume-Control/(notices)

Notices in the files:
hardware/usb_volume_control.kicad_pcb:
(C)2026 Kuro68k, rev 1
GPL v3
